g7ltt/Yet-another-Reflow-Oven/README.md

# Yet another Reflow Oven

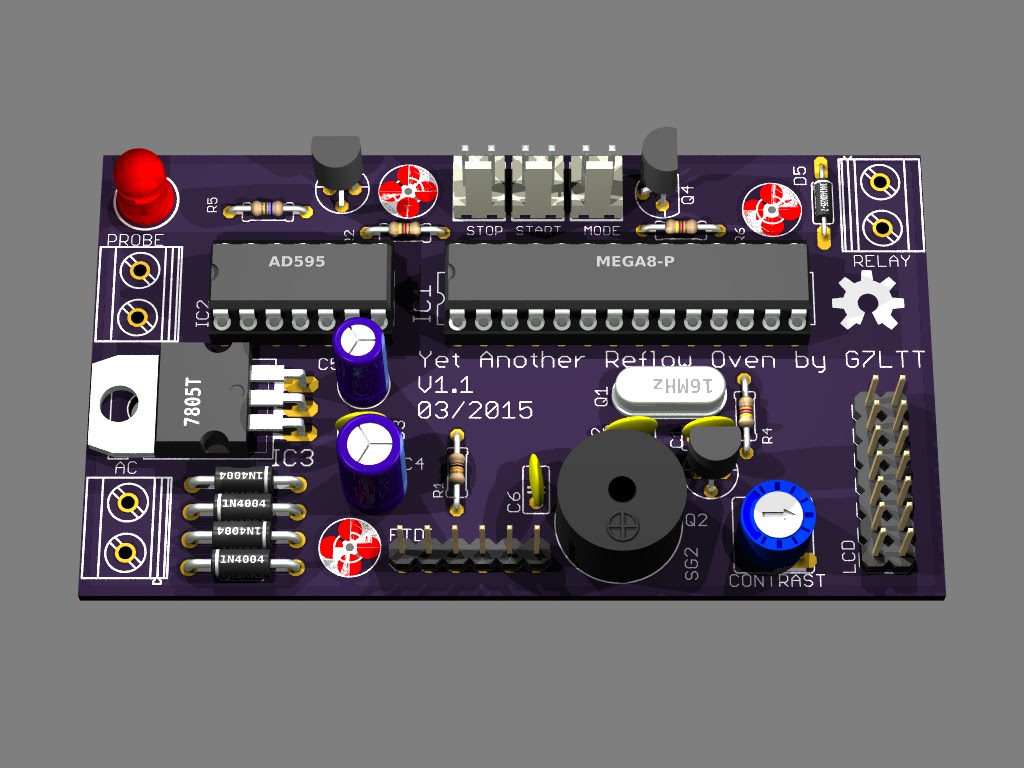
[picture p1: YARO.jpg]
yaro


http://g7ltt.blogspot.com/2015/03/yet-another-reflow-oven.html
