g7ltt/Yet-another-Reflow-Oven/IMG_20150320_170203.jpg

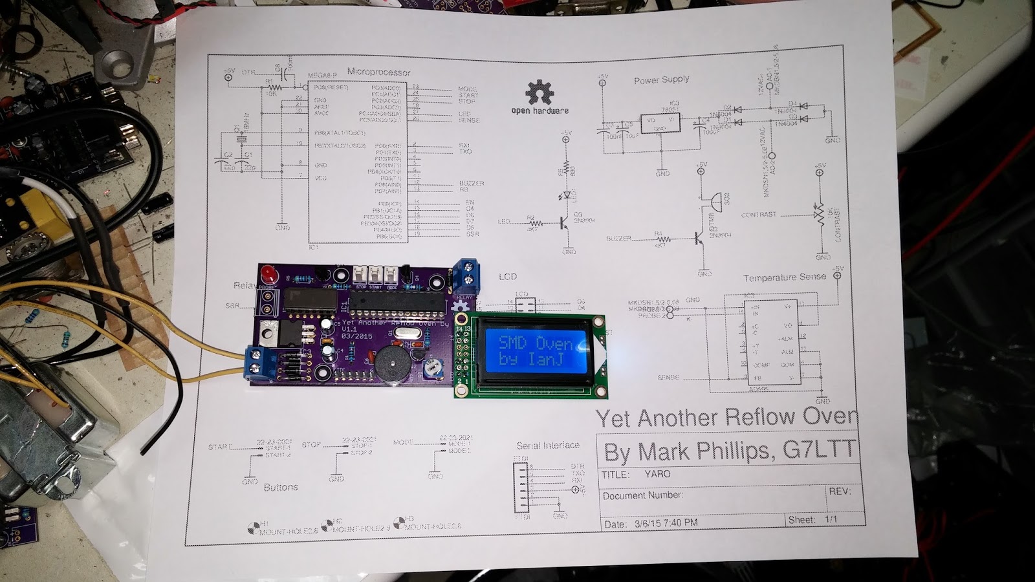
IMG_20150320_170203.jpg
