g7ltt/Yet-another-Reflow-Oven/YARO.pdf

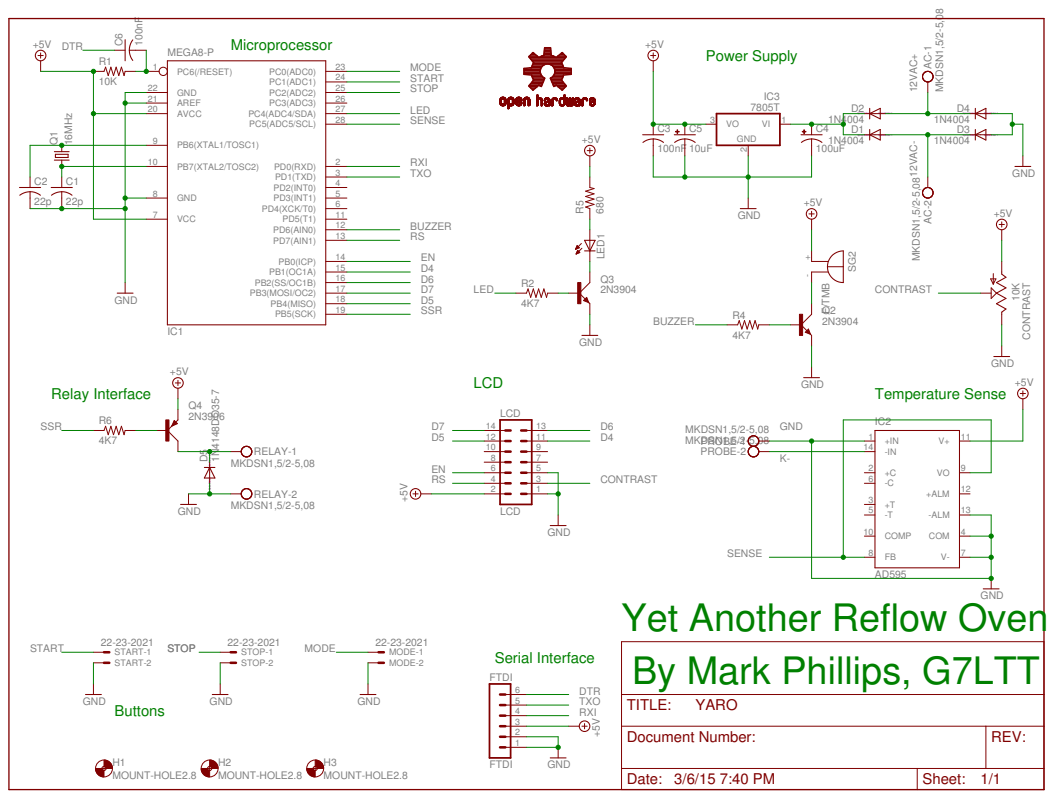
[picture p3: page 1]

GND
Yet Another Reflow Oven
By Mark Phillips, G7LTT

Document Number: | REV:

Date: 3/6/15 7:40 PM | Sheet: 1/1
