g7ltt/Yet-another-Reflow-Oven/YARO.brd

## EAGLE design YARO.brd (2021-09-01)

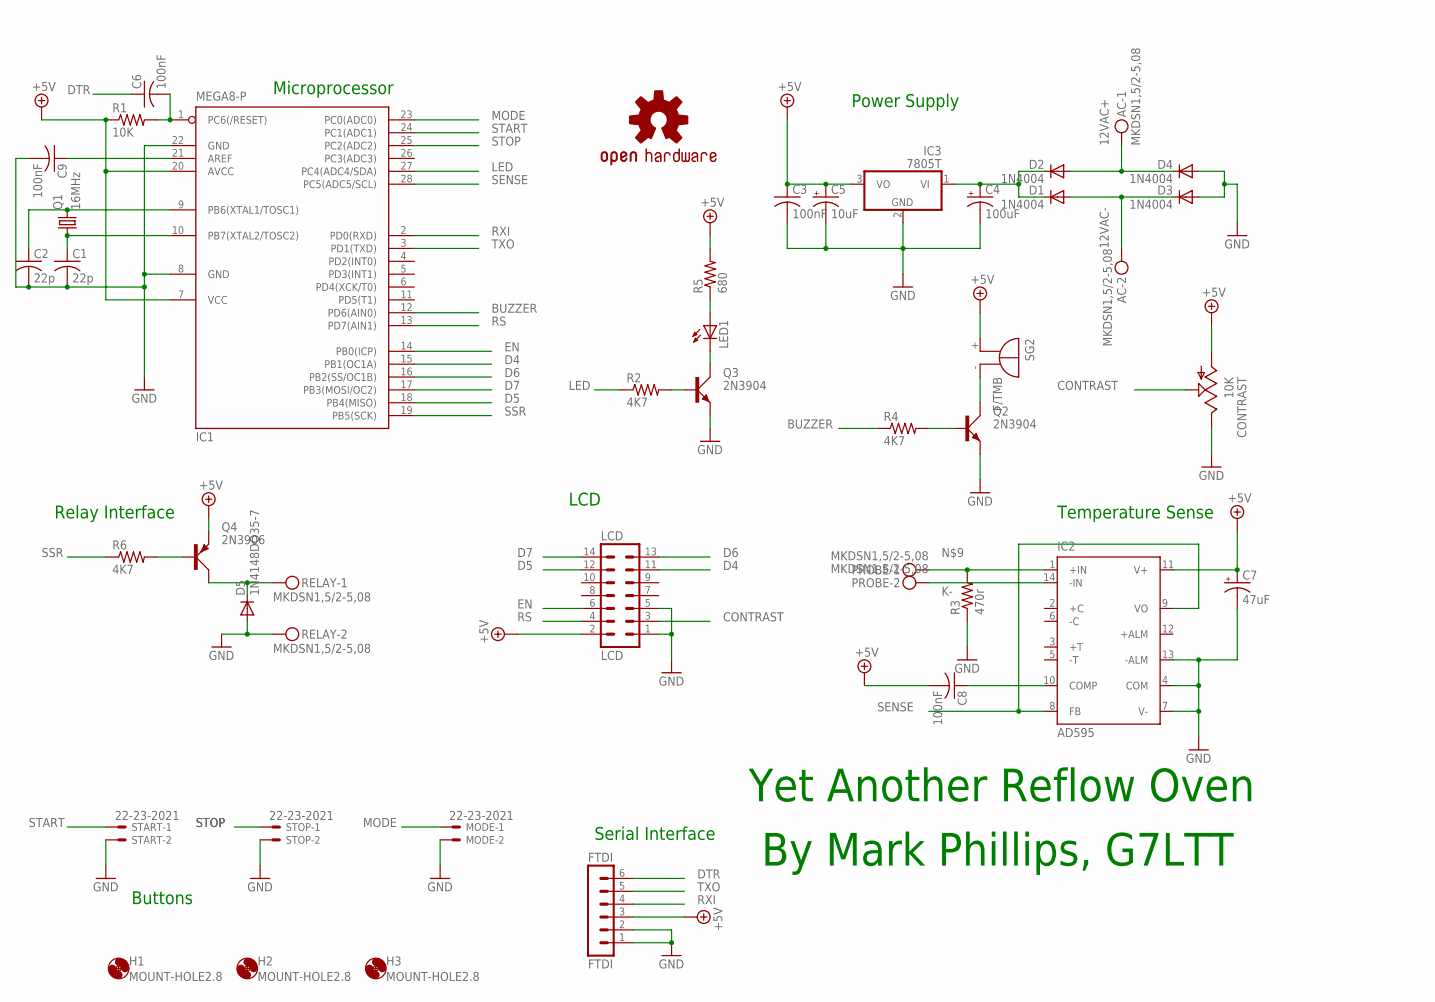
[picture p4: schematic YARO.sch]

Parts:
AC: MKDSN1,5/2-5,08
C1, C2: 22p; C025-025X050
C3, C6, C8, C9: 100nF; C025-025X050
C4: 100uF; E2,5-6
C5: 10uF; E2,5-5
C7: 47uF; E2,5-5
CONTRAST: 10K; CA6V
D1, D2, D3, D4: 1N4004; DO41-10
D5: 1N4148DO35-7; DO35-7
FTDI: FTDI; MA06-1
H1, H2, H3: MOUNT-HOLE2.8; 2,8
IC1: MEGA8-P; DIL28-3
IC2: AD595; DIL14
IC3: 7805T; TO220H
LCD: LCD; MA07-2
LED1: LED5MM
LOGO2: OSHW-LOGOL; OSHW-LOGO-L
MODE: 22-23-2021
PROBE: MKDSN1,5/2-5,08
Q1: 16MHz; HC49/S
Q2, Q3: 2N3904; TO92D
Q4: 2N3906; TO92D
R1: 10K; 0204/7
R2, R4, R6: 4K7; 0204/7
R3: 470r; 0204/7
R5: 680; 0204/7
RELAY: MKDSN1,5/2-5,08
SG2: F/TMB
START: 22-23-2021
STOP: 22-23-2021

Connections:
12VAC+: AC.1, D2.A, D4.C
12VAC-: AC.2, D1.A, D3.C
+5V: C3.1, C5.+, C7.+, C8.2, CONTRAST.A, FTDI.3, IC1.7 (VCC), IC1.20 (AVCC), IC2.11 (V+), IC3.3 (VO), LCD.2, Q4.E, R1.1, R5.2, SG2.+
BUZZER: IC1.12 (PD6(AIN0)), R4.1
CONTRAST: CONTRAST.S, LCD.3
D4: IC1.15 (PB1(OC1A)), LCD.11
D5: IC1.18 (PB4(MISO)), LCD.12
D6: IC1.16 (PB2(SS/OC1B)), LCD.13
D7: IC1.17 (PB3(MOSI/OC2)), LCD.14
DTR: C6.1, FTDI.6
EN: IC1.14 (PB0(ICP)), LCD.6
GND: C1.2, C2.2, C3.2, C4.-, C5.-, C7.-, C9.2, CONTRAST.E, D3.A, D4.A, D5.A, FTDI.1, FTDI.2, IC1.8 (GND), IC1.22 (GND), IC2.4 (COM), IC2.7 (V-), IC2.13 (-ALM), IC3.2 (GND), LCD.1, LCD.5, MODE.2, Q2.E, Q3.E, R3.1, RELAY.2, START.2, STOP.2
K-: IC2.14 (-IN), PROBE.2
LED: IC1.27 (PC4(ADC4/SDA)), R2.1
MODE: IC1.23 (PC0(ADC0)), MODE.1
unnamed: C2.1, IC1.9 (PB6(XTAL1/TOSC1)), Q1.2
unnamed: C1.1, IC1.10 (PB7(XTAL2/TOSC2)), Q1.1
unnamed: C4.+, D1.C, D2.C, IC3.1 (VI)
unnamed: C6.2, IC1.1 (PC6(/RESET)), R1.2
unnamed: Q3.B, R2.2
unnamed: LED1.K (C), Q3.C
unnamed: Q4.B, R6.2
unnamed: D5.C, Q4.C, RELAY.1
unnamed: IC2.1 (+IN), PROBE.1, R3.2
unnamed: C9.1, IC1.21 (AREF)
unnamed: C8.1, IC2.10 (COMP)
unnamed: Q2.C, SG2.-
unnamed: Q2.B, R4.2
unnamed: LED1.A, R5.1
RS: IC1.13 (PD7(AIN1)), LCD.4
RXI: FTDI.4, IC1.2 (PD0(RXD))
SENSE: IC1.28 (PC5(ADC5/SCL)), IC2.8 (FB), IC2.9 (VO)
SSR: IC1.19 (PB5(SCK)), R6.1
START: IC1.24 (PC1(ADC1)), START.1
STOP: IC1.25 (PC2(ADC2)), STOP.1
TXO: FTDI.5, IC1.3 (PD1(TXD))

Notes on the sheet:
Yet Another Reflow Oven
By Mark Phillips, G7LTT
Microprocessor
Power Supply
Temperature Sense
LCD
Serial Interface
Buttons
Relay Interface

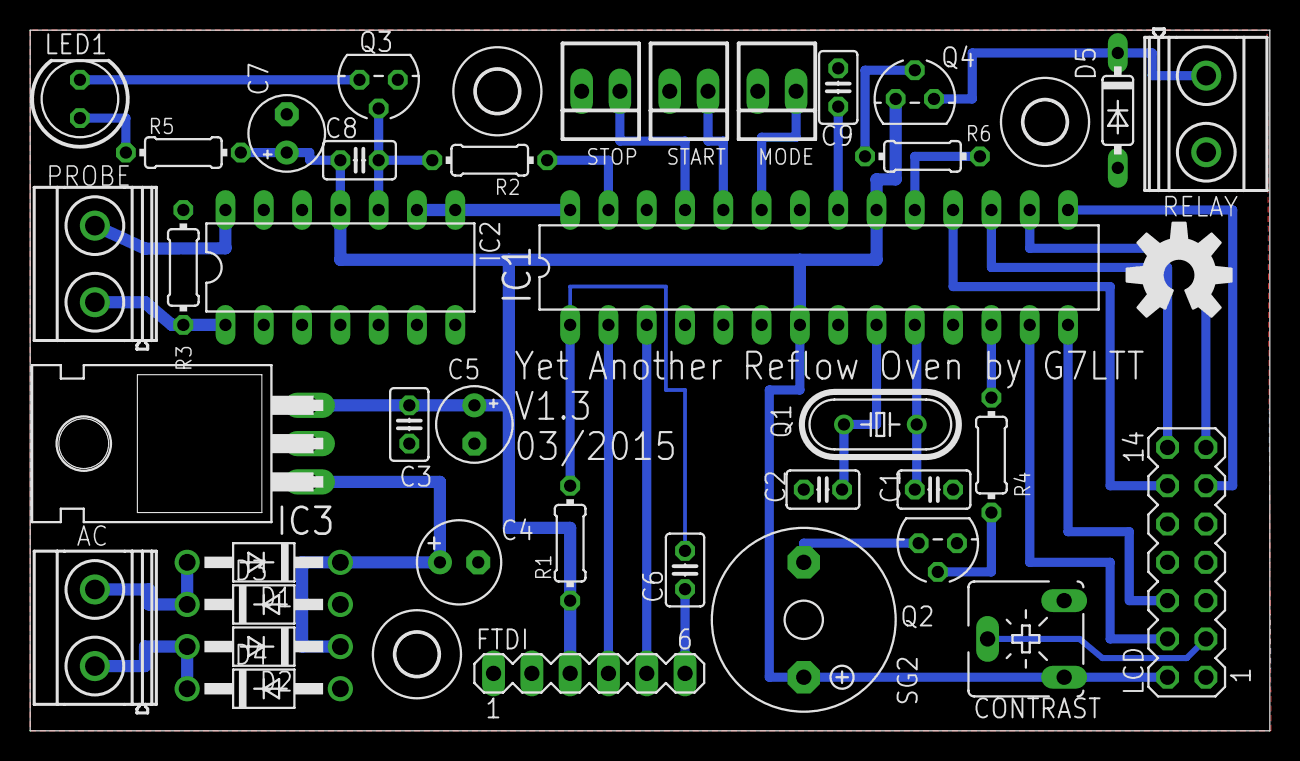
[picture p5: board YARO.brd from above]

Board: 2 copper layers, 82.2 x 46.5 mm, 42 parts (0 on the bottom side), 36 nets.
